daniel-lalegani/Project-Homay-Wearable-Gripper/media/960px-Scarlet_Macaw_(Ara_macao)_-Houston_Zoo-8.jpg

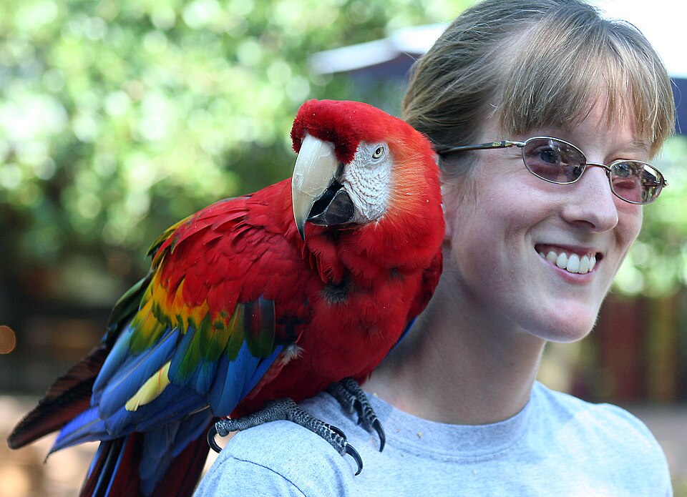
media/960px-Scarlet_Macaw_(Ara_macao)_-Houston_Zoo-8.jpg
