daniel-lalegani/Project-Homay-Wearable-Gripper/media/after connecting electronic boards.jpg

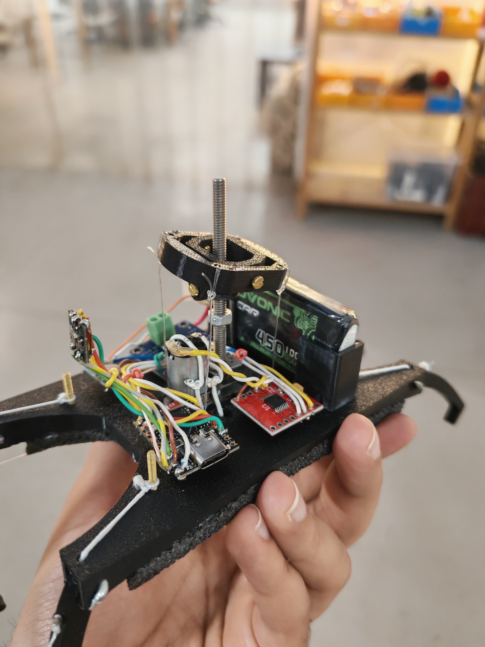
media/after connecting electronic boards.jpg
