daniel-lalegani/Project-Homay-Wearable-Gripper/media/electronic parts.jpg

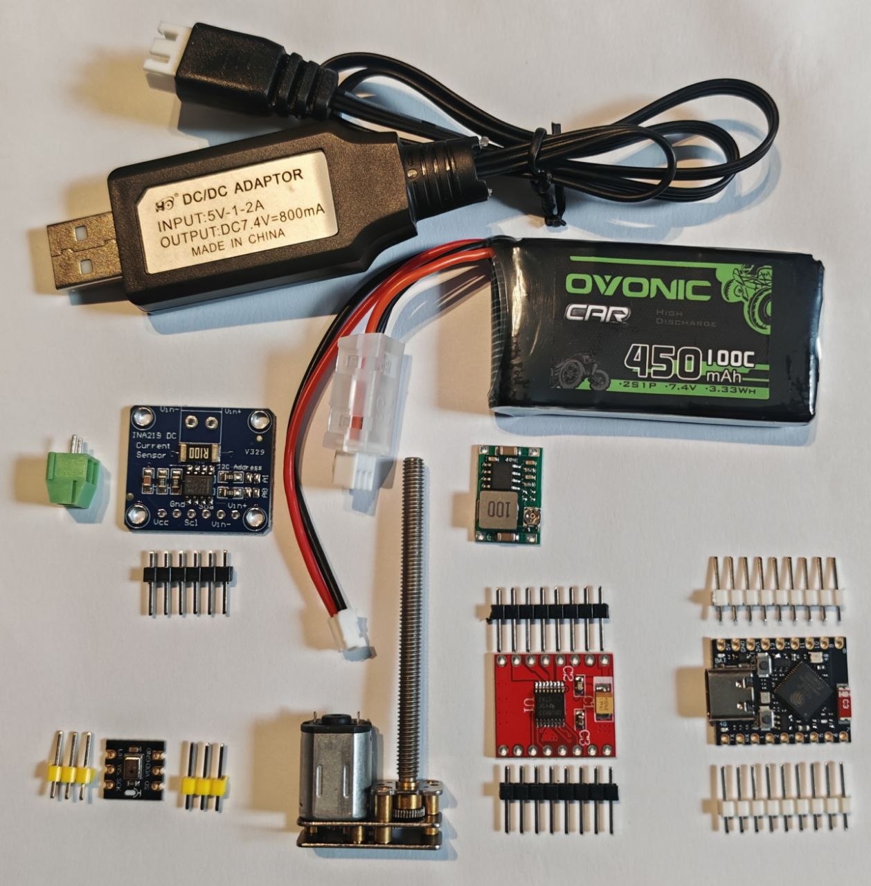
media/electronic parts.jpg
