daniel-lalegani/Project-Homay-Wearable-Gripper/homay assembly.step

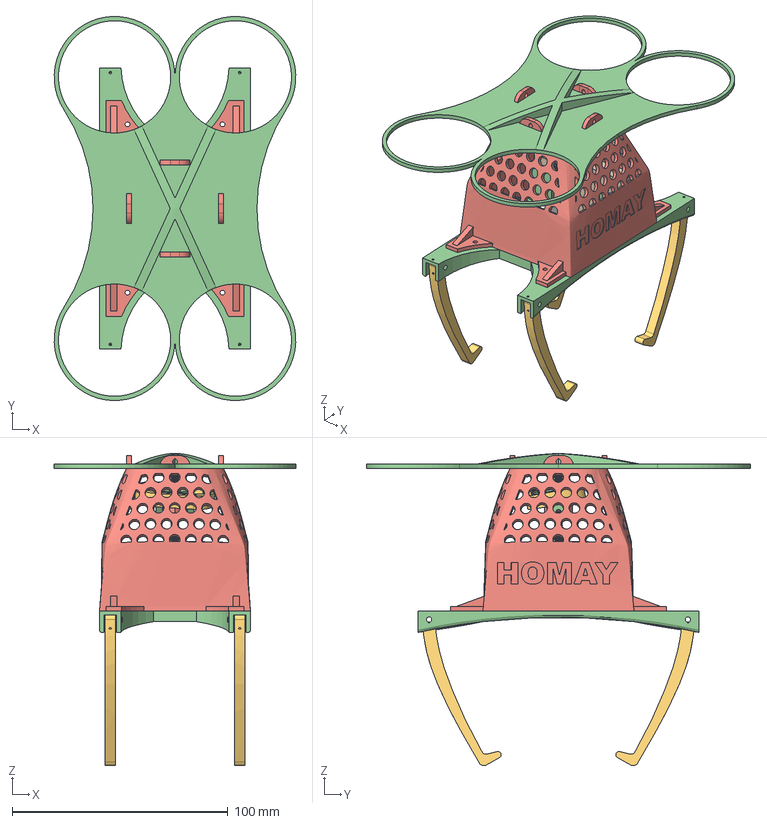
[picture p10: CAD file, 2026-10-31]
homay assembly.step
111.9 x 178.0 x 144.7 mm
