daniel-lalegani/Project-Homay-Wearable-Gripper/Schematic_Voice-Controlled-Adaptive-Robotic-Gripper_2026-10-28.pdf

# MINI360 , 7.4V to 5V

# INA219 Current Sensor

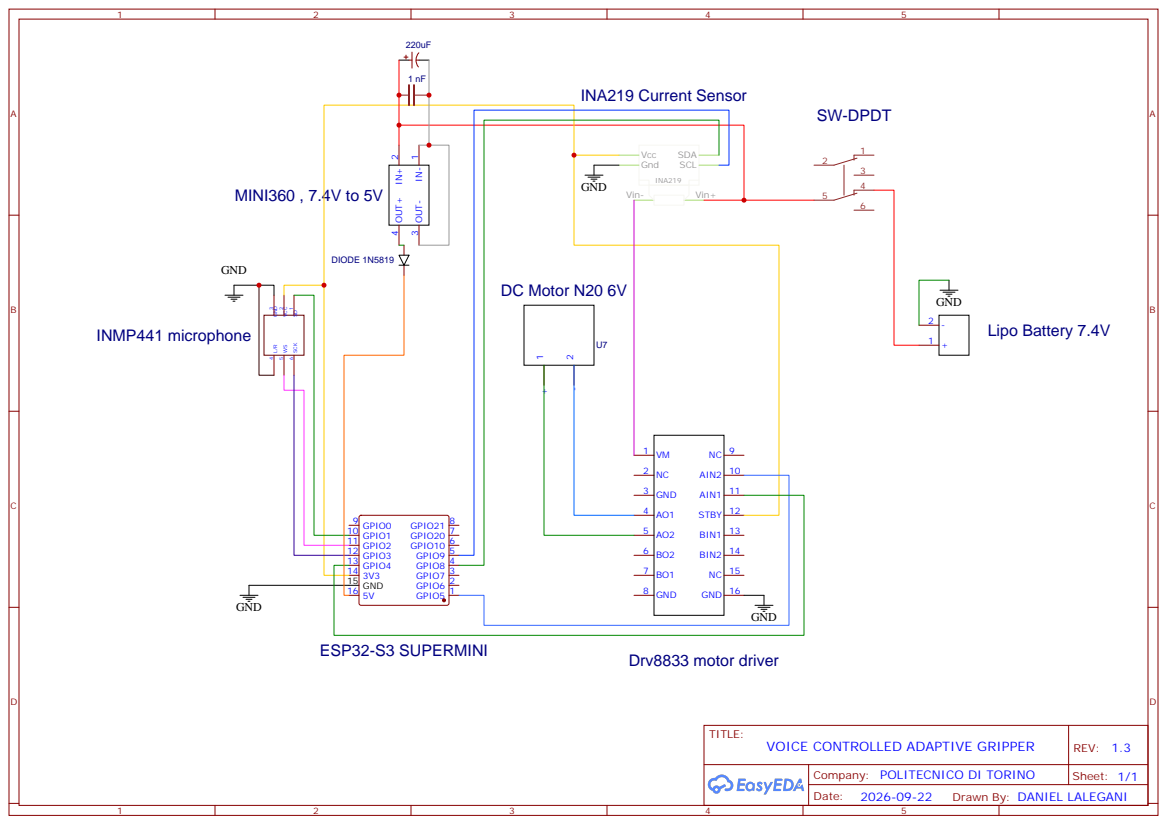
[picture p11: page 1]

Company: POLITECNICO DI TORINO

Drawn By: DANIEL LALEGANI
