daniel-lalegani/Project-Homay-Wearable-Gripper/(commit log)

2026-10-31 add Cad file
    [homay assembly.step]
2026-10-31 add schematic
2026-10-31 add arduino files
